brianthornock/StealthSustainer/README.md

# StealthSustainer
Guitar Sustainer Project Based on Original Sustainiac Stealth Sustainer
