brianthornock/StealthSustainer/Sustainer_Pole_Cap.step

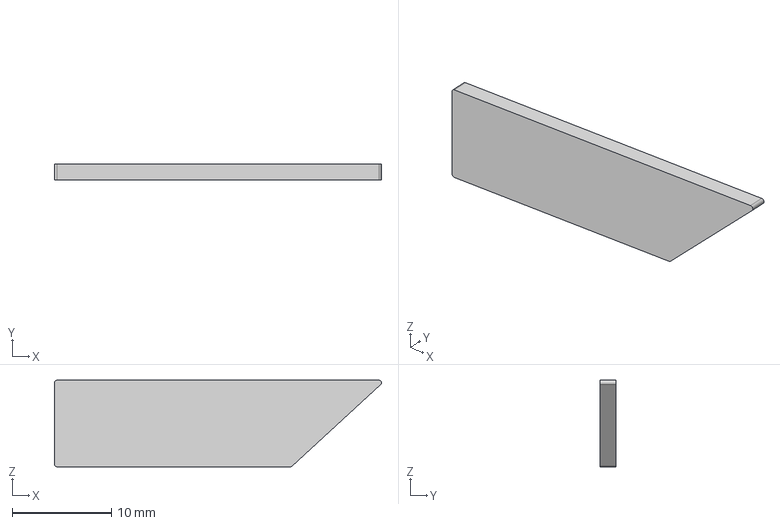
[picture p1: CAD file, 2023-10-29]
Sustainer_Pole_Cap.step
33.0 x 1.57 x 8.74 mm
