brianthornock/StealthSustainer/Sustainer Split Bobbin SmallerForBrackets v3.stl

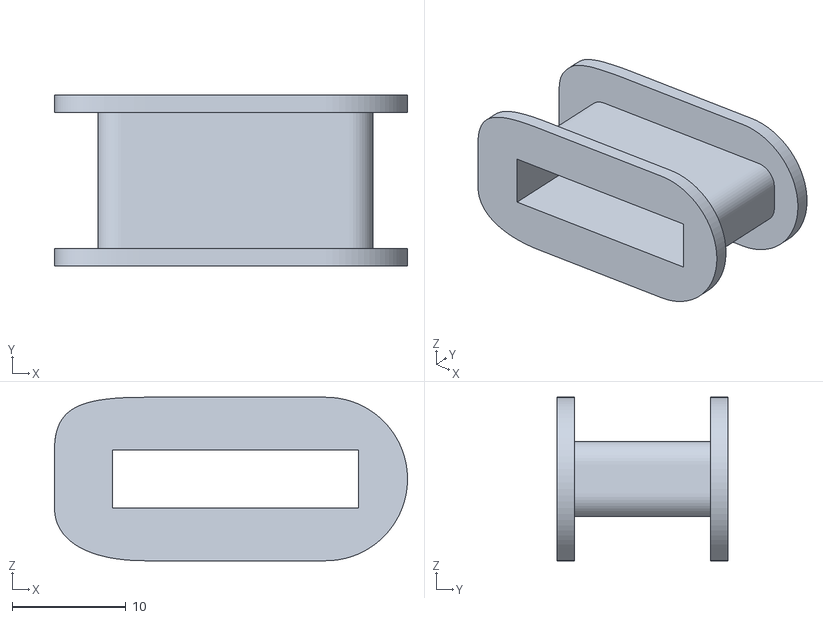
[picture p2: CAD file, 2023-10-29]
Sustainer Split Bobbin SmallerForBrackets v3.stl
31.0 x 15.0 x 14.4
