brianthornock/StealthSustainer/DriverCoilSteelBracket_UShaped_FlatPattern.dxf

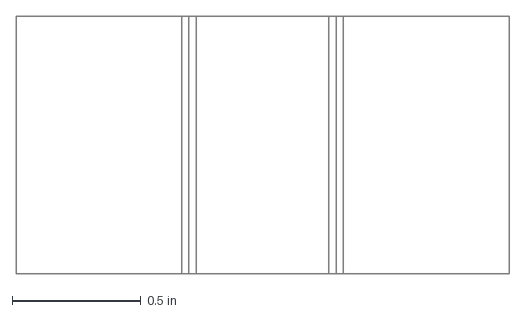
[picture p3: CAD file, 2023-10-29]
DriverCoilSteelBracket_UShaped_FlatPattern.dxf
1.92 x 1 in
