brianthornock/StealthSustainer/BobbinWinder v0.stl

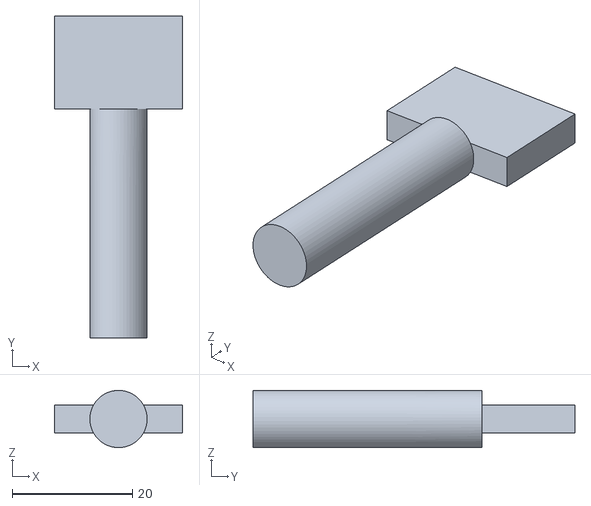
[picture p4: CAD file, 2023-08-26]
BobbinWinder v0.stl
21.3 x 53.6 x 9.52
