brianthornock/StealthSustainer/Sustainer Split Bobbin v2.stl

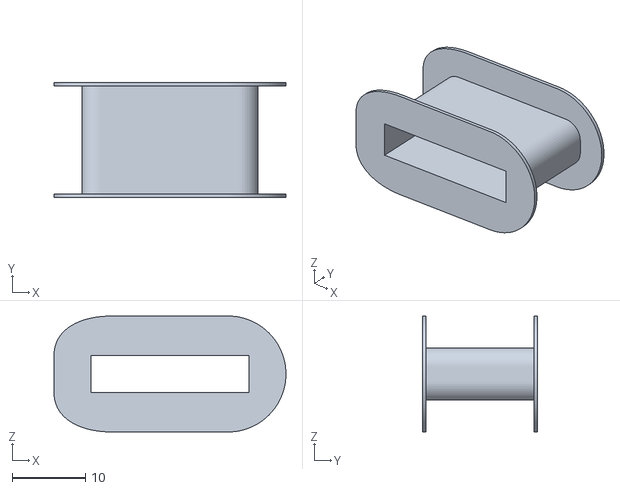
[picture p5: CAD file, 2023-08-26]
Sustainer Split Bobbin v2.stl
31.8 x 15.7 x 15.9
